SyncChannel/ATtiny104XNANO_AddOn/README.md

# ATtiny104XNANO_AddOn

Learning Embedded Electronics with the Atmel ATtiny104 Xplained NANO

See my blog post for more information:

http://syncchannel.blogspot.com/2016/05/learning-embedded-electronics-with.html
