SyncChannel/ATtiny104XNANO_AddOn/EagleFiles/ATtiny104XNANOaddon.brd

## EAGLE design EagleFiles/ATtiny104XNANOaddon.brd (2016-05-02)

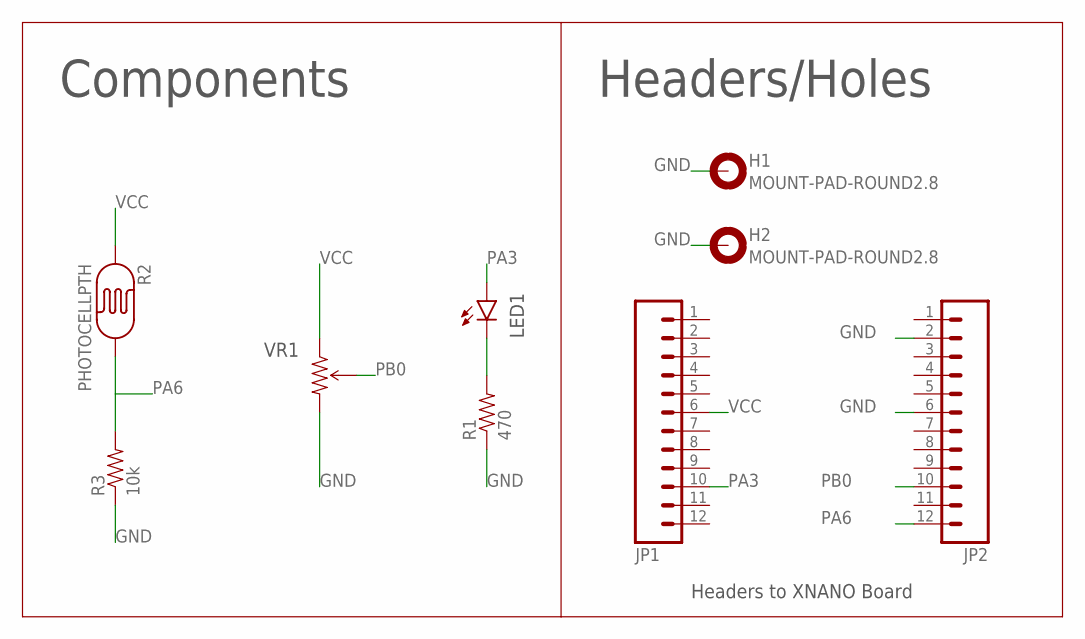
[picture p12: schematic ATtiny104XNANOaddon.sch]

Parts:
D1: LED5MM
H1, H2: MOUNT-PAD-ROUND2.8; 2,8-PAD
JP1, JP2: M12NO_SILK; 1X12_NO_SILK
R1: 470; AXIAL-0.4
R2: PHOTOCELLPTH; PHOTOCELL
R3: 10k; AXIAL-0.4
R4: TRIMPOT-PTH-KNOB; 3386U

Connections:
GND: H1.B2,8, H2.B2,8, JP2.2, JP2.6, R1.P$1 (1), R3.P$1 (1), R4.3 (CW)
LED1: D1.K (C), R1.P$2 (2)
PA3: D1.A, JP1.10
PA6: JP2.12, R2.2, R3.P$2 (2)
PB0: JP2.10, R4.2 (WIPER)
VCC: JP1.6, R2.1, R4.1 (CCW)

Notes on the sheet:
Headers to XNANO Board
VR1
Components
Headers/Holes
LED1

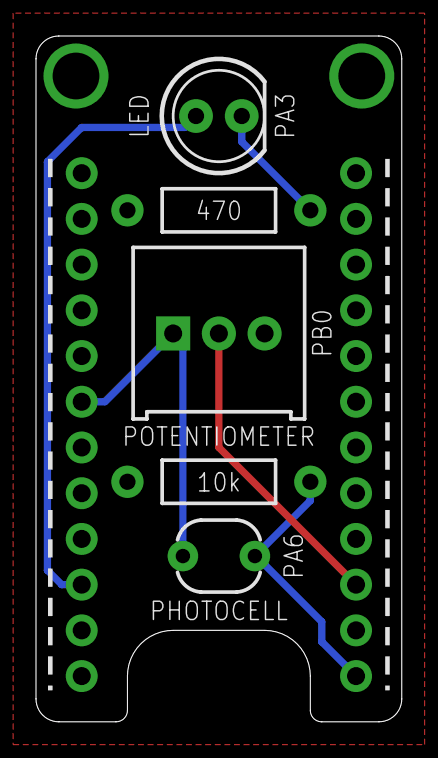
[picture p13: board ATtiny104XNANOaddon.brd from above]

Board: 2 copper layers, 20.3 x 38.1 mm, 10 parts (1 on the bottom side), 6 nets.

Other parts of the board:
U$1: OSHW-LOGO-S
